dsr987/autoheater-esp32/photos/IMG_20261018_200420_679.jpg

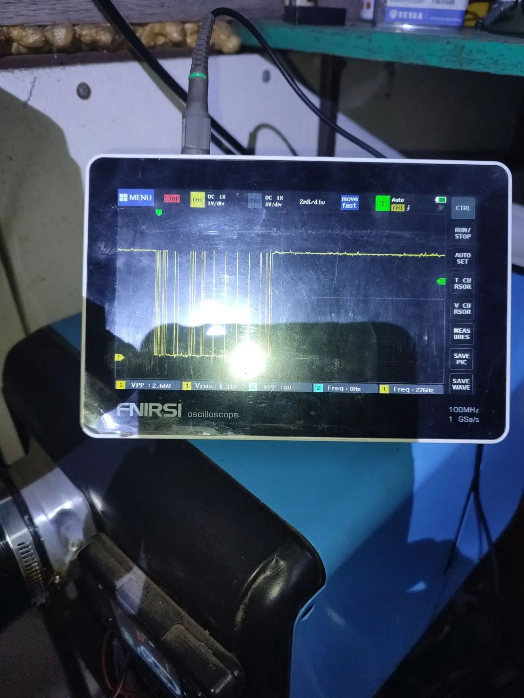
photos/IMG_20261018_200420_679.jpg
