dsr987/autoheater-esp32/photos/IMG_20261018_193747_767.jpg

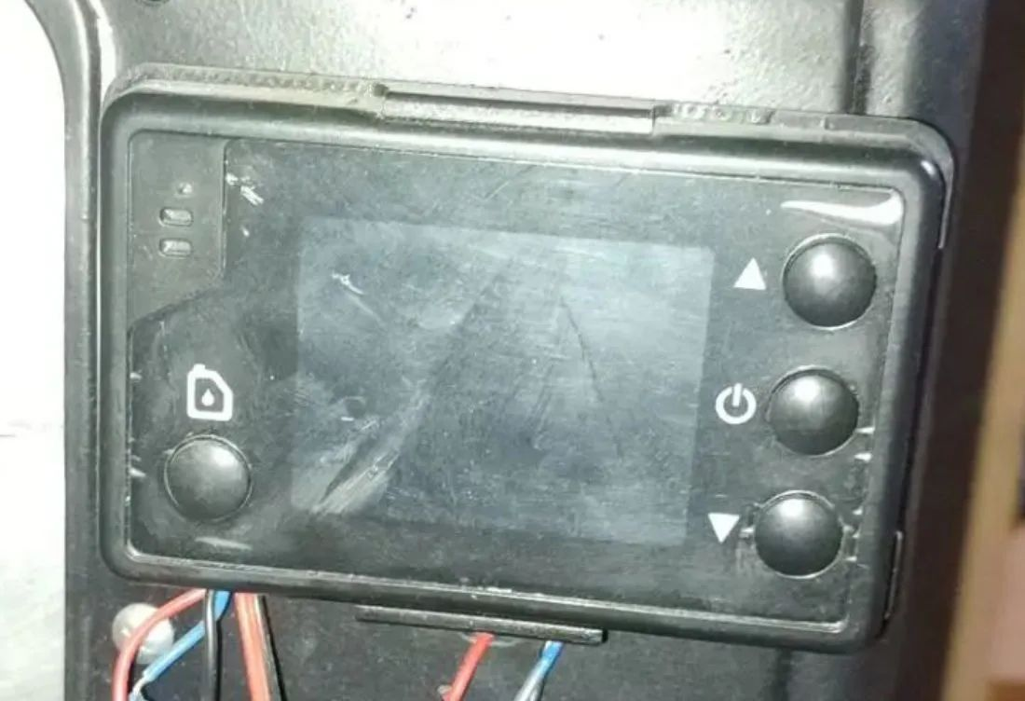
photos/IMG_20261018_193747_767.jpg
