dsr987/autoheater-esp32/docs/HEATER_PROTOCOL.md

# HEATER_PROTOCOL.md — протокол шины автономного отопителя (реверс)

Канонический документ проекта Autoheater ESP32. Статус: структура кадра, CRC и
основные команды подтверждены на 6 логах (~10 000 кадров). Семантика регистров —
рабочие гипотезы с указанием уверенности.

## 1. Физический уровень

- Полудуплексный UART по одному проводу, **9600 бод, 8N1**.
  Подтверждения: бит 104 мкс; межбайтовая пауза 1,032 мс = 10 бит; декодирование
  без framing errors; CRC сходится.
- Мастер — пульт (SYNC 0xA5), слейв — плата отопителя (SYNC 0xA0).
- Цикл опроса пульта: ~1,12-1,14 с (8 регистров подряд + телеметрия).
- Ответ слейва: через ~8-14 мс после запроса.
- Пауза мастера между кадрами: ~60-100 мс (окно для врезки).
- Записи пульт шлёт **троекратно** с интервалом ~21 мс.

## 2. Формат кадра

```
[SYNC][CMD][LEN_HI][LEN_LO][DATA x LEN][CRC8]
```

| Поле | Значение |
|---|---|
| SYNC | 0xA5 пульт, 0xA0 печка |
| CMD | 0x30 чтение регистра, 0x01 запись, 0x20 телеметрия пульта, 0x00 ответ слейва |
| LEN | длина DATA, 16 бит big-endian (00 01 / 00 02 / 00 04 / 00 05) |
| CRC | CRC-8/MAXIM: полином 0x31 (LSB-first 0x8C), init 0x00, без xorout; считается по байтам SYNC..конец DATA |

Кадры:
- чтение:   `A5 30 00 01 [reg] [CRC]`
- ответ:    `A0 00 00 XX [data] [CRC]` (XX = 01 или 04)
- запись:   `A5 01 00 05 [reg][float32 LE] [CRC]` (мощность) или
            `A5 01 00 02 [reg][байт] [CRC]` (старт/стоп)
- телеметрия пульта: `A5 20 00 05 [idx][float32 LE] [CRC]`, idx 0x00 = датчик пульта (°C), idx 0x01 = второй параметр (всегда 0.0)

## 3. Команды управления

- **Старт**: `0x02 = 00` x3, затем `0x03 = 01` x3
- **Стоп**:  `0x03 = 00` x3
- **Мощность**: запись `0x01`, float32 LE, ватты; ступени 1000/1900/2800/3700/4600
- **Важно**: пульт перезаписывает мощность (0x01) **каждый цикл опроса**, даже без
  нажатий. Врезка ESP32 с другим значением будет перезатираться — нужен оверрайд
  (своё значение догоняющим кадром после каждой чужой записи) или кнопки пульта.
- После стопа пульт делает один последний опрос 0x0B и замолкает: шина мертва,
  фаза продувки по ней не видна. Обойти можно только тихим опросом ESP32-мастера.

## 4. Регистры

| Рег | Формат | Наблюдаемое | Смысл (гипотеза) | Уверенность |
|---|---|---|---|---|
| 0x50 | u8 | 0x20/0x24/0x25/0x27/0x2F/0x2E | машина состояний | высокая |
| 0x0C | u32 | 2,4,5,6,7,9-11,13 | номер шага программы | высокая |
| 0x24 | f32 | 13,0-13,8 В | напряжение питания | высокая |
| 0x20 | f32 | 38..253 °C | температура узла печки | высокая |
| 0x16 | u32 | 0..4400 | обороты вентилятора | высокая |
| 0x10 | u32 | персистентный, тикает в рабочих фазах | счётчик доз топлива | средняя |
| 0x0B | u8 | 0xFF | код ошибки (FF = норма) | средняя |
| 0x03 | - | 0/1 | пуск/стоп (запись) | высокая |
| 0x01 | - | ватты | мощность (запись) | высокая |
| 0x02, 0x04, 0x05, 0x23, 0x66 | ? | 0/0,0219 | неизвестно | низкая |

Поправка: ранняя гипотеза «0x0C = уставка температуры» снята логом пуска.

## 5. Машина состояний (по логу полного пуска, мощность 5)

| 0x50 | Шаг | Фаза | Длительность |
|---|---|---|---|
| 0x20 | 2 | свеча/прогрев | ~3 с |
| 0x24 | 4-5 | розжиг: свеча+насос, вентилятор до ~2000 | ~90 с |
| 0x25 | 6 | пламя поймано, контроль горения | ~30 с |
| 0x27 | 7-8 | набор оборотов, частота доз растёт | ~30 с |
| 0x2F | 9-11 | выход на режим: вентилятор 1500->4400, свеча ещё работает | ~130 с |
| 0x2E | 13 | установившееся горение | до стопа |

- 0x10 (дозы) начинает тикать только с фазы 0x27.
- Напряжение проседает до ~13,0 В пока свеча работает; восстановление = свеча потухла.

## 6. Темп дозирования (0x10) по ступеням

| Мощность | Доз/с | Примечание |
|---|---|---|
| 1000 Вт | 1,7-2,3 | установившийся режим |
| 1900 Вт | 2,2-3,1 | |
| 2800 Вт | 2,4-3,7 | |
| 3700 Вт | 2,8-4,35 | |
| 4600 Вт | 4,4-4,6 | |

Вентилятор (0x16): 2400 на мощности 1, 4400 на мощности 5; переход занимает
десятки секунд (постоянная времени большая — короткие логи ловят только разгон).

## 7. Электрика подключения ESP32

- RX: делитель на синем проводе — 10 кОм последовательно, 20 кОм на GND
  (даёт 3,33 В на GPIO).
- TX: **только через диод 1N4148** (анод к линии, катод к TX ESP32). Когда TX=0,
  диод тянет линию к ~0,7 В; при TX=3,3 В диод заперт и линия висит на родной
  подтяжке 5 В. Так ESP32 физически не может пережать пульт/печку.
- GND общий. Питание ESP32 — от +5 В печки через VIN или свой DC-DC.
- UART ESP32: один пин на TX+RX (полудуплекс) или раздельные пины; эхо своей
  передачи глушить по времени (в коде — suppressUntil).

## 8. Реализация прошивки

Единственный актуальный исходник прошивки находится в корне репозитория: `App.ino`.
Единственный исходник веб-интерфейса — корневой `index.html`. Перед компиляцией
скрипт `tools/prepare_sketch.py` создаёт временную Arduino-папку и встраивает
HTML в заголовок `web_page.h`. Первоначальная USB-установка выполняется общей
прошивкой [ESP32 Factory](https://github.com/dsr987/esp32-factory) с профилем
**Basic**; локального установочного скетча в этом проекте нет.

Используется стандартная таблица разделов Arduino-ESP32 с двумя OTA-слотами.
Пользовательская таблица разделов в репозитории не задаётся.

Реализация должна соответствовать кадрам, CRC, регистрам и командам из разделов
1–7. Подробная схема подключения находится в `HARDWARE_ASSEMBLY.md`.

## 9. Чек-лист первого пуска

1. **Только сниффер.** Ничего не нажимать в вебе; запустить печку родным пультом
   и сверить показания дашборда с поведением печки (ступени, температура, обороты).
2. **Пуск через веб** на холодной печке при включённом пульте. Слушать щелчки
   насоса, следить за 0x50.
3. **Мощность +/-**: менять в вебе, сверять обороты 0x16; проверить оверрайд.
4. **Стоп через веб**: пульт продолжит опрос — увидим коды продувки в 0x50
   (бонус: закроем недостающую фазу остановки).
5. **Пуск на молчащей шине** (после родного стопа): проверить, принимает ли
   печка команды от нас, когда пульт уснул. Непроверенное допущение.

## 10. Открытые вопросы

- Что за регистры 0x02/0x04/0x05/0x23/0x66.
- Сброс счётчика 0x10 между сессиями (3 разных несмонотонных значения).
- Словарь ошибок 0x0B (ждём лог с ошибкой).
- Фаза продувки: только через ESP32-мастер после стопа.
- Приемлемость врезок вне цикла пульта (проверяется пуском №2-3).
