dsr987/autoheater-esp32/docs/improvement.md

# Дополнительные предложения и технические решения

В этом документе собраны предложения для последующих отдельных задач и решения, принятые при настройке OTA. Предложения не означают, что соответствующие изменения уже реализованы.

## Текущая конфигурация разделов и OTA

Проект использует стандартную таблицу разделов default.csv из Arduino-ESP32 2.0.9. Собственная таблица partitions.csv в репозитории не применяется.

Для классической ESP32 с flash 4 МБ стандартная таблица содержит два OTA-раздела приложения:

| Раздел | Смещение | Размер | Назначение |
|---|---:|---:|---|
| app0 | 0x10000 | 0x140000 | Первый слот приложения |
| app1 | 0x150000 | 0x140000 | Второй слот приложения |

Размер каждого слота — 1 310 720 байт (1,25 МиБ). CI проверяет, что собранное приложение не превышает 0x140000. Проект рассчитан на классическую ESP32 с flash 4 МБ и стандартный профиль платы Arduino-ESP32.

Первоначальная USB-установка выполняется общей прошивкой [ESP32 Factory](https://github.com/dsr987/esp32-factory): для Autoheater следует выбрать профиль **Basic**. После установки Factory загрузи `autoheater-esp32.bin` через ElegantOTA. Дальнейшие обновления также выполняются только app-only файлом.

## Дополнительные предложения

### 1. Разделить статистику кадров

Сейчас `validFrames` учитывает CRC-корректные кадры штатного пульта и принятые ответы отопителя. Для диагностики полезно отдельно считать:
- все кадры с корректным CRC;
- кадры с ошибкой CRC;
- ответы с корректным CRC, но неожиданным регистром или длиной.

Это позволит отличать физические ошибки передачи от ошибок сопоставления кадров.

### 2. Защитить сопоставление ответов с запросами

Ожидающий ответ описывается одним `pendingRegister` и общим тайм-аутом. Если ответ задержится, а на шине появится следующий запрос, теоретически возможна неоднозначность.

Предложение: сначала собрать логи с реальной шины, а затем при необходимости рассмотреть очередь ожидаемых запросов или дополнительную проверку временного окна. При ранее наблюдавшейся задержке около 14 мс это не выглядит срочным дефектом.

### 3. Добавить диагностику подавления эха

Для `consumeEcho()` полезны отдельные счётчики полностью подавленных эхо-кадров, частичных совпадений и истёкших окон эха. Это позволит проверять механизм по логам без изменения его алгоритма.

### 4. Уточнить смысл индикатора «Телеметрия устарела»

Сейчас таймер страницы отслеживает отсутствие любых WebSocket-сообщений, а не возраст последнего ответа отопителя. Это корректно как индикатор потери обновлений интерфейса, но не является независимой проверкой свежести телеметрии. Если понадобится точная диагностика, стоит передавать время последнего ответа отопителя или возраст данных отдельным полем.

### 5. Проверить OTA на реальном устройстве

После первой USB-прошивки с новой таблицей разделов рекомендуется:
1. проверить, что устройство загружается с новой разметкой;
2. выполнить OTA-обновление;
3. убедиться, что после перезагрузки запустился новый слот;
4. повторить OTA, чтобы проверить обратное переключение на второй слот;
5. проверить поведение при прерывании загрузки обновления.

### 6. Проверить запас размера приложения

При каждом релизе нужно контролировать размер бинарного файла: он должен быть меньше размера одного OTA-слота (`0x140000` байт). При приближении к лимиту следует пересмотреть таблицу разделов или состав прошивки до того, как обновление перестанет помещаться.

## Неизменённые ограничения

- Аппаратные испытания с реальным отопителем ещё не подтверждены.
- Разделы рассчитаны на 4 МБ flash; объём памяти конкретной платы следует подтвердить.
- Успешная компиляция сама по себе не доказывает корректность UART-обмена, запуска отопителя или OTA на устройстве.
