dsr987/autoheater-esp32/photos/README.md

В данной папке находятся фотографии и файлы необходимые для взаимодействия в чате
