dsr987/autoheater-esp32/docs/PROTOCOL_ADDENDUM_1.md

# HEATER_PROTOCOL — дополнение 1 (состояния и коды ошибок)

## Коды ошибок (регистр 0x0B) — текущий статус

Специфические коды ошибок **пока не расшифрованы**. Проверено по всем 8 логам:
в регистре `0x0B` встречалось единственное значение — `0xFF` (норма). Коды ошибок
появятся только в логах, снятых во время реальной неисправности (см. «Как поймать»).

До появления таких логов в прошивке действует заглушка: любое значение `0x0B != 0xFF`
выводится как «Ошибка 0xXX — проверьте отопитель».

## Уточнения таблицы состояний (найдено при перепроверке логов)

- **Шаг 1 существует**: сразу после записи старта (`0x03=1`) ~0,4 с печка держит
  `0x0C = 1`, затем переходит на шаг 2 (`0x20`, свеча). В основной таблице шаг 1
  не значился.
- **`0x50 = 0x38` — транзиентное состояние внутри фазы `0x2F`**: в большом логе
  пуска на шаге 9 состояние на один цикл опроса (~1 с) переключалось
  `0x2F → 0x38 → 0x2F`. Вероятно, кратковременный подэтап (проверка пламени /
  импульс насоса). Не самостоятельная фаза, в таблицу состояний вносить как
  «транзиент внутри 0x2F».

## Как поймать коды ошибок (для следующего лога)

1. **Нехватка топлива**: дождаться почти пустого бака / перекрыть подачу на
   работающей печке — ждать сообщения об ошибке на пульте, запись продолжать
   минимум 2 мин после появления.
2. **Срыв пламени**: попытка пуска с заблокированной подачей топлива (дозатор
   отсоединить или пережать трубку) — свеча отработает, пламя не появится.
3. **Перегрев** (осторожно, если позволяет конструкция): перекрыть воздухозаборник.
4. После появления ошибки **не выключать питание** сразу: желательно снять лог
   с попыткой авторестарта (многие отопители делают 2–3 попытки розжига, затем
   финальная ошибка) — заодно увидим коды продувки в `0x50`.

## Наблюдение после остановки отопителя (2026-11-09)

Во время аппаратного теста пользователь остановил работающий отопитель. В регистре
состояния 0x50 после команды STOP наблюдалось значение 0x04, пока вентилятор
продолжал работать в фазе продувки. После завершения продувки и остановки
вентилятора появилось 0x00.

Рабочая гипотеза:
- 0x04 — продувка / охлаждение камеры после остановки;
- 0x00 — ожидание / остановленное состояние после продувки.

Это наблюдение получено на одном описанном цикле остановки. Семантика 0x04 и
0x00 пока не считается подтверждённой: нужны повторные логи с временной
привязкой к фактической работе вентилятора. До подтверждения прошивка показывает
эти подписи с пометкой «гипотеза» и сохраняет переходы в диагностическом журнале.
