dsr987/autoheater-esp32/docs/HARDWARE_ASSEMBLY.md

# Сборка аппаратной части Autoheater ESP32

Документ описывает подключение классической ESP32 DevKit к штатной однопроводной шине отопителя и OLED-дисплею. Проект подключается параллельно штатному пульту: пульт остаётся подключённым.

## 1. Комплектующие

Обязательные:
- ESP32 DevKit на классическом ESP32 (ESP32-WROOM-32 или совместимая плата).
- Резистор 10 кОм, 1 шт.
- Резистор 20 кОм, 1 шт.
- Диод 1N4148, 1 шт.
- Провода, монтажная плата, изоляция и корпус.

Дополнительно:
- OLED 128×64 на SSD1306 с интерфейсом I²C.
- USB-кабель для первой прошивки и диагностики.

Питание ESP32: стабильные 5 В на вход VIN/5V платы либо питание от USB. Не подавайте 5 В на вывод 3V3. Питание от отопителя через его линию +5 В допускается только после измерения напряжения и проверки, что источник способен питать ESP32. Если это не подтверждено, используйте отдельный стабилизированный DC-DC 5 В.

## 2. Распиновка ESP32

| Сигнал | ESP32 | Подключение |
|---|---:|---|
| UART RX | GPIO16 | DATA отопителя через делитель 10 кОм / 20 кОм |
| UART TX | GPIO17 | DATA отопителя только через диод 1N4148 |
| OLED SDA | GPIO21 | SDA дисплея |
| OLED SCL | GPIO22 | SCL дисплея |
| Питание | VIN/5V | Стабилизированные 5 В |
| Земля | GND | Общая земля ESP32, дисплея и отопителя |

UART работает на 9600 бод, 8N1. OLED ожидается с адресом I²C 0x3C.

## 3. Подключение линии DATA

Подключение выполняется параллельно штатному пульту. Штатный пульт остаётся подключённым.

### Вход ESP32 (RX)

На синем проводе DATA может присутствовать логический уровень около 5 В. Подключать его напрямую к GPIO16 нельзя.

Соберите делитель:
- DATA отопителя → резистор 10 кОм → GPIO16;
- GPIO16 → резистор 20 кОм → GND.

При уровне DATA 5 В на GPIO16 получится примерно 3,33 В.

### Выход ESP32 (TX)

Между GPIO17 и DATA обязательно установите диод 1N4148:
- анод диода (сторона без полосы) → линия DATA;
- катод диода (сторона с полосой) → GPIO17.

Не подключайте GPIO17 напрямую к DATA. Диод нужен для развязки выхода ESP32 от штатной линии.

### Общая земля

Соедините GND ESP32 с GND отопителя. Без общей земли UART не получит надёжный опорный уровень.

## 4. OLED-дисплей

Если используется SSD1306 128×64 I²C:
- VCC → питание, допустимое для конкретного модуля (проверьте маркировку платы);
- GND → GND ESP32;
- SDA → GPIO21;
- SCL → GPIO22.

Логические линии I²C должны быть подтянуты к 3,3 В, а не к 5 В. Если модуль питается от 5 В и имеет подтяжки SDA/SCL к VCC, проверьте схему модуля до подключения к ESP32.

## 5. Питание

1. До монтажа измерьте напряжение на предполагаемом источнике питания.
2. На VIN/5V ESP32 подавайте только стабильные 5 В.
3. Не соединяйте 12/24 В отопителя с выводами питания ESP32.
4. Не подавайте внешние 5 В одновременно с USB, если конкретная DevKit не имеет проверенной схемы развязки источников.
5. При питании от отдельного DC-DC объедините его GND с GND отопителя и ESP32.

## 6. Схема соединений

~~~text
             Штатный пульт
                  |
                  | DATA (синий провод)
                  +-------------------------------+
                  |                               |
               10 кОм                         анод 1N4148
                  |                               |
                  +---- GPIO16              катод (полоса)
                  |                               |
               20 кОм                         GPIO17
                  |
                 GND

Отопитель GND -------- ESP32 GND -------- OLED GND
Стабилизированные 5 В ------------------- ESP32 VIN/5V

ESP32 GPIO21 ---------------------------- OLED SDA
ESP32 GPIO22 ---------------------------- OLED SCL
ESP32 3V3 ------------------------------- OLED VCC (если модуль рассчитан на 3,3 В)
~~~

## 7. Порядок сборки

1. Полностью обесточьте отопитель и отключите USB от ESP32.
2. Установите резисторы делителя RX и диод TX. Проверьте номиналы и ориентацию диода.
3. Подключите общий GND.
4. Подключите GPIO16 к DATA через делитель, GPIO17 к DATA через 1N4148.
5. Подключите OLED, если он используется. До подачи питания проверьте, что SDA/SCL не подтянуты к 5 В.
6. Подключите питание ESP32 от проверенного источника 5 В.
7. Осмотрите монтаж: между 5 В и GND не должно быть короткого замыкания; DATA не должна иметь прямого соединения с GPIO.
8. Первую прошивку выполните по USB согласно разделу установки в README.
9. После загрузки прошивки подключитесь телефоном или компьютером к Wi-Fi Autoheater и откройте http://192.168.4.1/.
10. Сначала проверьте только чтение телеметрии при работе штатного пульта. Команды управления проверяйте отдельно, на безопасной и контролируемой установке.

## 8. Контроль перед подключением

- [ ] На GPIO16 нет прямого соединения с DATA: установлен делитель 10 кОм / 20 кОм.
- [ ] На GPIO17 нет прямого соединения с DATA: установлен 1N4148, полоса обращена к GPIO17.
- [ ] GND ESP32 соединён с GND отопителя.
- [ ] На VIN/5V ESP32 подаётся только проверенное питание 5 В.
- [ ] На GPIO ESP32 не подаётся 5 В.
- [ ] Штатный пульт остался подключённым.
- [ ] Нет оголённых проводников и возможности короткого замыкания.

## 9. Ограничения и безопасность

- Не подключайте ESP32 к неизвестным проводам отопителя методом проб и ошибок. Перед монтажом определите DATA, GND и источник питания по документации именно вашего отопителя.
- Не вмешивайтесь в силовые цепи свечи, насоса и вентилятора. Эта схема касается только низковольтного интерфейса пульта.
- Не оставляйте отопитель без присмотра во время первых испытаний.
- При нестабильном питании, перегреве проводов, сбоях штатного пульта или неожиданном поведении немедленно отключите дополнительный модуль.
- Компиляция прошивки не подтверждает электрическую совместимость с конкретной моделью отопителя. Аппаратные испытания обязательны.
