dsr987/autoheater-esp32/CHANGELOG.md

# История версий

## 0.0.4
- Подтверждено состояние 0x00 (ожидание); гипотезой остаётся только 0x04 (продувка после STOP).
- Добавлен Wi-Fi Dual Mode: постоянная точка доступа и подключение к домашней сети с сохранением настроек.

## 0.0.3
- Обновлён мобильный Web GUI: название проекта и версия сборки в шапке, индикаторы RSSI/override, полноэкранный портретный режим и увеличенные кнопки управления.
- OLED упрощён: кириллический шрифт, ступень мощности 1–5, температура и краткое состояние на русском.
- Счётчики валидных кадров и CRC перенесены в диагностику; добавлен кольцевой журнал неизвестных состояний, ошибок, регистров и кадров с временными метками, копированием и TXT-экспортом.
- Состояния 0x04 (предположительно продувка после STOP) и 0x00 (предположительно ожидание) отмечены как гипотезы до повторной аппаратной проверки.

## 0.0.2
- Первая рабочая реализация протокола A5/A0: телеметрия, управление и веб-интерфейс.
- Встроены CRC-8/MAXIM, контроль тайм-аутов ответов и тихий опрос после остановки штатного пульта.
- Пуск доступен без телеметрии; приоритет heaterPower при отображении мощности; поле hp.

## 0.0.1
- Первая рабочая реализация протокола A5/A0: телеметрия, управление и веб-интерфейс.
- Встроены CRC-8/MAXIM, контроль тайм-аутов ответов и тихий опрос после остановки штатного пульта.
