dsr987/autoheater-esp32/(commit log)

2026-10-18 docs: define staged ESP32 firmware plan
2026-10-18 Document missing model marking and planned board photos
2026-10-18 feat: port release versioning automation (#1)
    * feat: port release versioning automation
    * feat: add post-merge release version automation
    * docs: finish release versioning transfer
    * docs: finish release versioning transfer
    * docs: finish release versioning transfer
    * docs: add release versioning guide
    * fix: add matching Arduino sketch entry point
    * fix: keep Arduino sketch entry point minimal
    * feat: add web page interface declarations
    * feat: add responsive heater dashboard without websocket
    * feat: start protected local dashboard and access point
    * fix: package application binary from matching sketch name
    * fix: remove mismatched Arduino sketch entry point
    * docs: describe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
2026-10-18 Тест автоматики
2026-10-19 Добавить пассивный перехват линии BM и проверку протокола (#2)
    * Add RX-only BM wiretap sketch
    * Document passive BM wiretap setup
    * Document passive BM wiretap setup
    * Configure UART RX buffer before begin
    * Add reference protocol decoder and OLED telemetry
    * Document reference decoder and OLED compatibility test
    * Перевести инструкцию пассивного перехвата на русский
    * Перевести заметки по подключению линии BM на русский
    * Уточнить русские названия и описания в основном README
2026-10-19 Добавить автоматическую сборку экспериментов ESP32
2026-10-19 Исправить имя выходного BIN для ESP32
2026-10-19 Сохранять BIN рядом со скетчами
2026-10-19 Обновить бинарники экспериментов ESP32
2026-10-22 Добавить ElegantOTA в эксперимент wiretap_line_bm (#3)
    * Добавить ElegantOTA в wiretap эксперимент
    * Описать OTA и подключение входного интерфейса
    * Добавить OTA-зависимости в CI сборку экспериментов
    * Исправить выбор библиотеки Async TCP для сборки OTA
    * Pin ESP32 OTA build toolchain to LEGO project configuration
    [wiretap_line_bm.ino]
2026-10-22 Добавить мобильный веб-мониторинг wiretap BM (#4)
    * Add phone-accessible live wiretap monitor and debug log
    * Fix serial log mirroring implementation
    * Correct include and browser log newline
    [wiretap_line_bm.ino]
2026-10-22 Fix escaped quotes in wiretap status JSON (#5)
    [wiretap_line_bm.ino]
2026-10-22 CI: проверять метки релиза до слияния PR (#6)
    * ci: validate release metadata before merge
    * ci: validate release metadata on every PR
2026-10-23 Add persistent raw UART capture and downloadable logs (#10)
    * Add persistent raw UART capture and downloadable logs
    * Log raw UART bytes and explain frame validation
    * Fix JSON escaping in log status endpoint
    * Document persistent wiretap log and download controls
    * Correct JSON string escaping for log status
    * Batch raw UART log lines to reduce serial overhead
    * Reset in-memory preview when clearing persistent log
    [wiretap_line_bm.ino]
2026-10-23 Make wiretap the primary firmware and fix log actions (#11)
    * Move wiretap firmware into primary build tree
    * Build wiretap as the primary OTA firmware
    * Point experiment documentation to primary wiretap firmware
    * Document wiretap as the primary firmware
    * Compile only actual experiment source files
    * Move wiretap source to primary firmware build
    * Remove stale experiment binary after moving wiretap to primary build
    * Limit experiment builds to source changes
    [wiretap_line_bm.ino]
2026-10-23 Use firmware/app as the single primary application (#12)
    * Use passive wiretap as the primary app sketch
    * Keep release metadata without duplicate app runtime
    * Build firmware from firmware/app
    * Document app as the single primary firmware
    * Remove duplicate wiretap source after moving it into app
2026-10-23 Fix wiretap log download and RAM fallback
2026-10-23 Document passive UART baud diagnostic
2026-10-23 Add passive UART baud-rate sweep diagnostics (#16)
    * Add passive UART baud-rate diagnostic sweep
    * Tag UART gaps with active baud rate
    * Document passive UART baud diagnostic
    * Fix newline escapes in baud sweep log markers
    * Fix stale baud constant in setup log
2026-10-23 Fix UART capture at 9600 baud for protocol experiment (#20)
2026-10-23 Add Up/Down timestamp markers to web log (#22)
    * Add web UI markers for Up and Down button presses
    * Fix newline escaping in button marker handlers
    * Correct marker handler string escaping
    * Finalize newline escape in marker log lines
    * Use standard newline escape in marker log lines
2026-11-03 Загружена документация по взлому протокола
2026-11-03 обновил документацию
2026-11-03 обновил heater_protocol.md
2026-11-03 Replace agent instructions with a placeholder
    Removed detailed agent instructions and added a placeholder for current instructions.
2026-11-03 Revise project description in README.md
    Updated the README to provide a current project description and removed outdated sections.
2026-11-03 Rebuild Autoheater ESP32 firmware and release pipeline (#25)
    * Replace legacy wiretap with documented heater protocol
    * Track register for ESP32 silent polling responses
    * Align documentation with HEATER_PROTOCOL
    * Align documentation with HEATER_PROTOCOL
    * Align documentation with HEATER_PROTOCOL
    * Align documentation with HEATER_PROTOCOL
    * Align documentation with HEATER_PROTOCOL
    * Align documentation with HEATER_PROTOCOL
    * Associate silent-poll replies with transmitted register
    * Resolve UART pin wording against documented pinout
    * Update contributor safety policy for documented heater protocol
    * Remove obsolete pre-protocol experiment
    * Remove obsolete pre-protocol experiment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
    [App.ino]
2026-11-03 Apply heater protocol review fixes
    [App.ino]
2026-11-03 Allow start command without heater telemetry
2026-11-03 Add dual-slot OTA partition table for 4MB ESP32
    [partitions.csv]
2026-11-03 Fix OTA partition table overlap
    [partitions.csv]
2026-11-03 Add generated factory Arduino sketch
2026-11-03 Add factory partition table
    [partitions.csv]
2026-11-03 Generate factory image with ESP32 2.0.9 esptool
2026-11-03 Document factory image assembly
2026-11-04 Return to standard ESP32 OTA partition layout (#26)
    * Use standard ESP32 partitions for factory sketch
    * Stop copying obsolete custom partition table
    * Build firmware with standard ESP32 OTA partition scheme
    * Add complete ESP32 hardware assembly guide
    * Update installation instructions for standard OTA layout
    * Document standard OTA partition configuration
    * Update protocol guide for standard partition layout
    * Remove obsolete custom partition table
    * Remove obsolete custom partition table
    * Add manual versioned release publishing
    * Fix firmware version extraction for manual release
    [partitions.csv]
2026-11-05 Release 0.0.2: patch heater power display and startup (#27)
    * Bump firmware to 0.0.2 and report heater power
    * Correct standard OTA slot size in improvement notes
    * Generate changelog for firmware 0.0.2
    * Update README firmware version to 0.0.2
    * Regenerate factory sketch from App.ino
    * Build Autoheater app-only firmware and use shared Factory repository
    * Remove project-specific factory; use shared esp32-factory
    * Remove project-specific factory; use shared esp32-factory
    * Document shared Factory and app-only Autoheater releases
    * Fix release documentation after Factory separation
    * Retry transient ESP32 core download failures in CI
    * Restore pyserial required by ESP32 esptool du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
    [App.ino]
2026-11-05 docs: закрепить профиль Basic и общую ESP32 Factory (#28)
    * Документировать установку Autoheater через Factory Release
    * Удалить устаревшие инструкции локальной Factory
    * Обновить описание первой установки в протоколе
    * Удалить остаток локальной Factory
    * Уточнить ссылку на релиз ESP32 Factory
    * Уточнить имя архива ESP32 Factory
2026-11-09 feat: обновить мобильный Web GUI и диагностику (#29)
    * feat: refresh mobile GUI and add protocol diagnostics
    * fix: render active Wi-Fi signal bars
    * fix: synchronize generated changelog with firmware markers
    * docs: keep firmware changelog scoped to 0.0.3
    * docs: align 0.0.3 changelog with new release notes
    * fix: clarify diagnostic frame length
    * docs: explain diagnostic ring buffer retention
    [App.ino]
2026-11-09 fix: safe area и компактный русский OLED (#30)
    * fix(gui): respect bottom safe area
    * fix(oled): use ASCII state labels
    * fix(gui): limit spacing change to bottom safe area
    * feat(oled): render compact Russian status screen
    * build: install Cyrillic OLED font support
    * docs: record Russian OLED screen update
    [App.ino]
2026-11-13 0.0.4 Wi-Fi Dual Mode (#31)
    * feat: add Wi-Fi AP+STA mode
    * feat: add Wi-Fi configuration UI
    * docs: describe Wi-Fi dual mode
    * docs: update changelog for 0.0.4
    * refactor: remove obsolete AP client RSSI helper
    * docs: clarify Wi-Fi credential storage
    * docs: preserve previous changelog entries
    * fix: avoid duplicate Wi-Fi modal element id
    * docs: clarify Wi-Fi access addresses
    * fix: keep release changelog metadata in sync
    [App.ino]
